bodri/RcReceiver/RcReceiver.kicad_pcb

## KiCad design RcReceiver.kicad_pcb (2019-04-16)

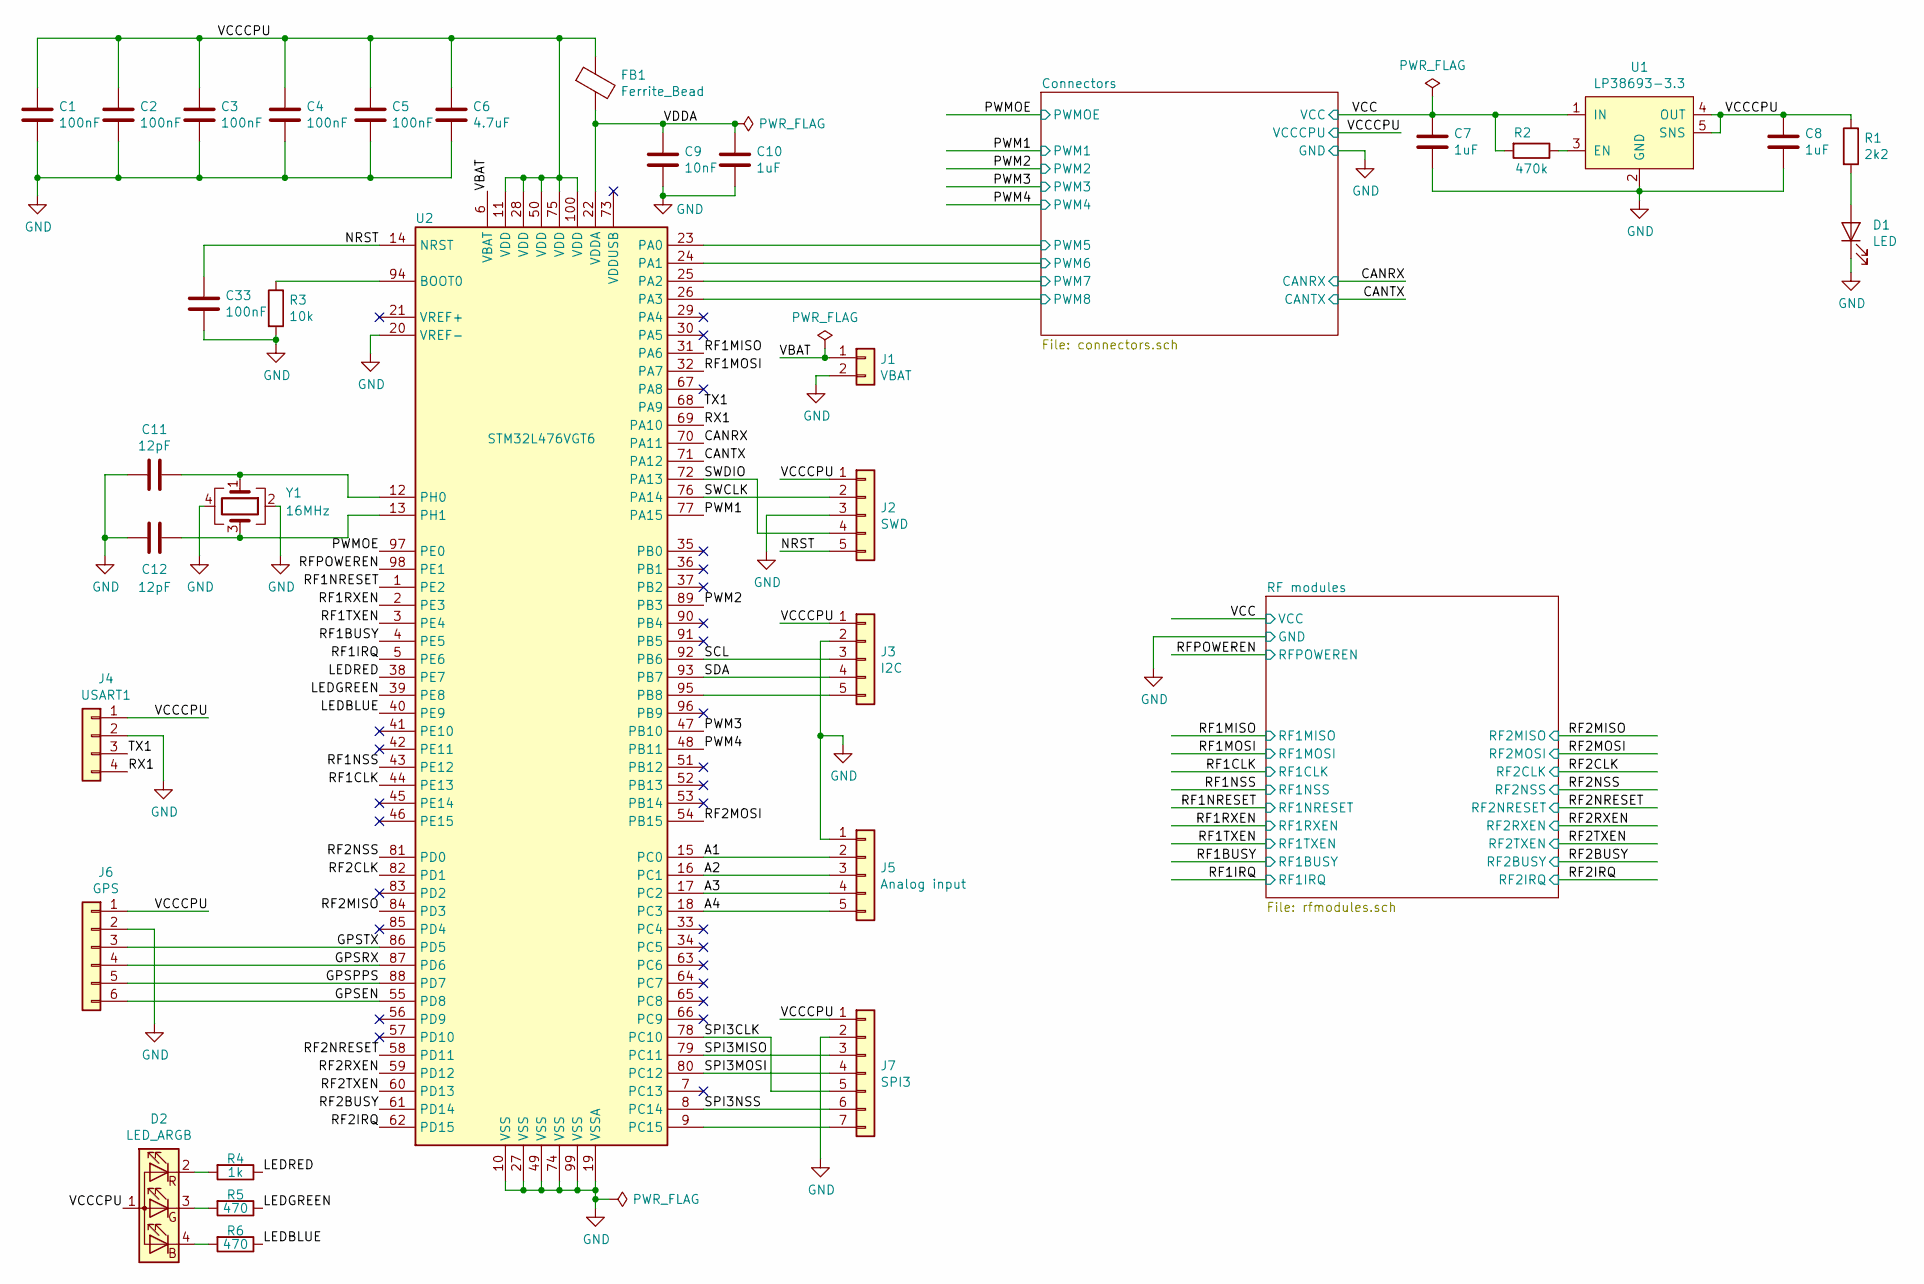
[picture p1: schematic RcReceiver.sch, SX1280 based RC receiver]

Parts:
C1, C2, C3, C4, C5, C33: 100nF; C_0402_1005Metric
C6: 4.7uF; C_0402_1005Metric
C7, C8, C10: 1uF; C_0402_1005Metric
C9: 10nF; C_0402_1005Metric
C11, C12: 12pF; C_0402_1005Metric
D1: LED; LED_0402_1005Metric
D2: LED_ARGB; LED_Lumex-LX0404
FB1: Ferrite_Bead; L_0402_1005Metric
J1: VBAT; PinHeader_1x02_P1.27mm_Vertical
J2: SWD; JST_SH_BM05B-SRSS-TB_1x05-1MP_P1.00mm_Vertical
J3: I2C; JST_SH_BM05B-SRSS-TB_1x05-1MP_P1.00mm_Vertical
J4: USART1; JST_SH_BM04B-SRSS-TB_1x04-1MP_P1.00mm_Vertical
J5: Analog input; JST_SH_BM05B-SRSS-TB_1x05-1MP_P1.00mm_Vertical
J6: GPS; JST_SH_BM06B-SRSS-TB_1x06-1MP_P1.00mm_Vertical
J7: SPI3; JST_SH_BM07B-SRSS-TB_1x07-1MP_P1.00mm_Vertical
R1: 2k2; R_0402_1005Metric
R2: 470k; R_0402_1005Metric
R3: 10k; R_0402_1005Metric
R4: 1k; R_0402_1005Metric
R5, R6: 470; R_0402_1005Metric
U1: LP38693-3.3; WSON-6_3x3mm_Pitch0.95mm
U2: STM32L476VGT6; LQFP-100_14x14mm_P0.5mm
Y1: 16MHz; Oscillator_SMD_SeikoEpson_SG210-4Pin_2.5x2.0mm

Connections:
/A1: J5.2, U2.15 (PC0)
/A2: J5.3, U2.16 (PC1)
/A3: J5.4, U2.17 (PC2)
/A4: J5.5, U2.18 (PC3)
/CANRX: U2.70 (PA11); also elsewhere on the board
/CANTX: U2.71 (PA12); also elsewhere on the board
/Connectors/PWM5: U2.23 (PA0); also elsewhere on the board
/Connectors/PWM6: U2.24 (PA1); also elsewhere on the board
/Connectors/PWM7: U2.25 (PA2); also elsewhere on the board
/Connectors/PWM8: U2.26 (PA3); also elsewhere on the board
/GPSEN: J6.6, U2.55 (PD8)
/GPSPPS: J6.5, U2.88 (PD7)
/GPSRX: J6.4, U2.87 (PD6)
/GPSTX: J6.3, U2.86 (PD5)
/LEDBLUE: R6.1, U2.40 (PE9)
/LEDGREEN: R5.1, U2.39 (PE8)
/LEDRED: R4.1, U2.38 (PE7)
/NRST: C33.1, J2.5, U2.14 (NRST)
/PWM1: U2.77 (PA15); also elsewhere on the board
/PWM2: U2.89 (PB3); also elsewhere on the board
/PWM3: U2.47 (PB10); also elsewhere on the board
/PWM4: U2.48 (PB11); also elsewhere on the board
/PWMOE: U2.97 (PE0); also elsewhere on the board
/RF1BUSY: U2.4 (PE5); also elsewhere on the board
/RF1CLK: U2.44 (PE13); also elsewhere on the board
/RF1IRQ: U2.5 (PE6); also elsewhere on the board
/RF1MISO: U2.31 (PA6); also elsewhere on the board
/RF1MOSI: U2.32 (PA7); also elsewhere on the board
/RF1NRESET: U2.1 (PE2); also elsewhere on the board
/RF1NSS: U2.43 (PE12); also elsewhere on the board
/RF1RXEN: U2.2 (PE3); also elsewhere on the board
/RF1TXEN: U2.3 (PE4); also elsewhere on the board
/RF2BUSY: U2.61 (PD14); also elsewhere on the board
/RF2CLK: U2.82 (PD1); also elsewhere on the board
/RF2IRQ: U2.62 (PD15); also elsewhere on the board
/RF2MISO: U2.84 (PD3); also elsewhere on the board
/RF2MOSI: U2.54 (PB15); also elsewhere on the board
/RF2NRESET: U2.58 (PD11); also elsewhere on the board
/RF2NSS: U2.81 (PD0); also elsewhere on the board
/RF2RXEN: U2.59 (PD12); also elsewhere on the board
/RF2TXEN: U2.60 (PD13); also elsewhere on the board
/RFPOWEREN: U2.98 (PE1); also elsewhere on the board
/RX1: J4.4, U2.69 (PA10)
/SCL: J3.3, U2.92 (PB6)
/SDA: J3.4, U2.93 (PB7)
/SPI3CLK: J7.5, U2.78 (PC10)
/SPI3MISO: J7.3, U2.79 (PC11)
/SPI3MOSI: J7.4, U2.80 (PC12)
/SPI3NSS: J7.6, U2.8 (PC14)
/SWCLK: J2.2, U2.76 (PA14)
/SWDIO: J2.4, U2.72 (PA13)
/TX1: J4.3, U2.68 (PA9)
/VBAT: J1.1, U2.6 (VBAT)
/VCCCPU: C1.1, C2.1, C3.1, C4.1, C5.1, C6.1, C8.1, D2.1 (A), FB1.1, J2.1, J3.1, J4.1, J6.1, J7.1, R1.1, U1.4 (OUT), U1.5 (SNS), U2.11 (VDD), U2.28 (VDD), U2.50 (VDD), U2.75 (VDD), U2.100 (VDD); also elsewhere on the board
/VDDA: C9.1, C10.1, FB1.2, U2.22 (VDDA)
GND: C1.2, C2.2, C3.2, C4.2, C5.2, C6.2, C7.2, C8.2, C9.2, C10.2, C11.2, C12.2, C33.2, D1.1 (K), J1.2, J2.3, J3.2, J4.2, J5.1, J6.2, J7.2, R3.2, U1.2 (GND), U1.7 (GND), U2.10 (VSS), U2.19 (VSSA), U2.20 (VREF-), U2.27 (VSS), U2.49 (VSS), U2.74 (VSS), U2.99 (VSS), Y1.2, Y1.4; also elsewhere on the board
IN: C7.1, R2.2, U1.1 (IN), U1.6 (IN); also elsewhere on the board
unnamed: C11.1, U2.12 (PH0), Y1.1
unnamed: C12.1, U2.13 (PH1), Y1.3
unnamed: D1.2 (A), R1.2
unnamed: D2.2 (RK), R4.2
unnamed: D2.3 (GK), R5.2
unnamed: D2.4 (BK), R6.2
unnamed: J3.5, U2.95 (PB8)
unnamed: J7.7, U2.9 (PC15)
unnamed: R2.1, U1.3 (EN)
unnamed: R3.1, U2.94 (BOOT0)

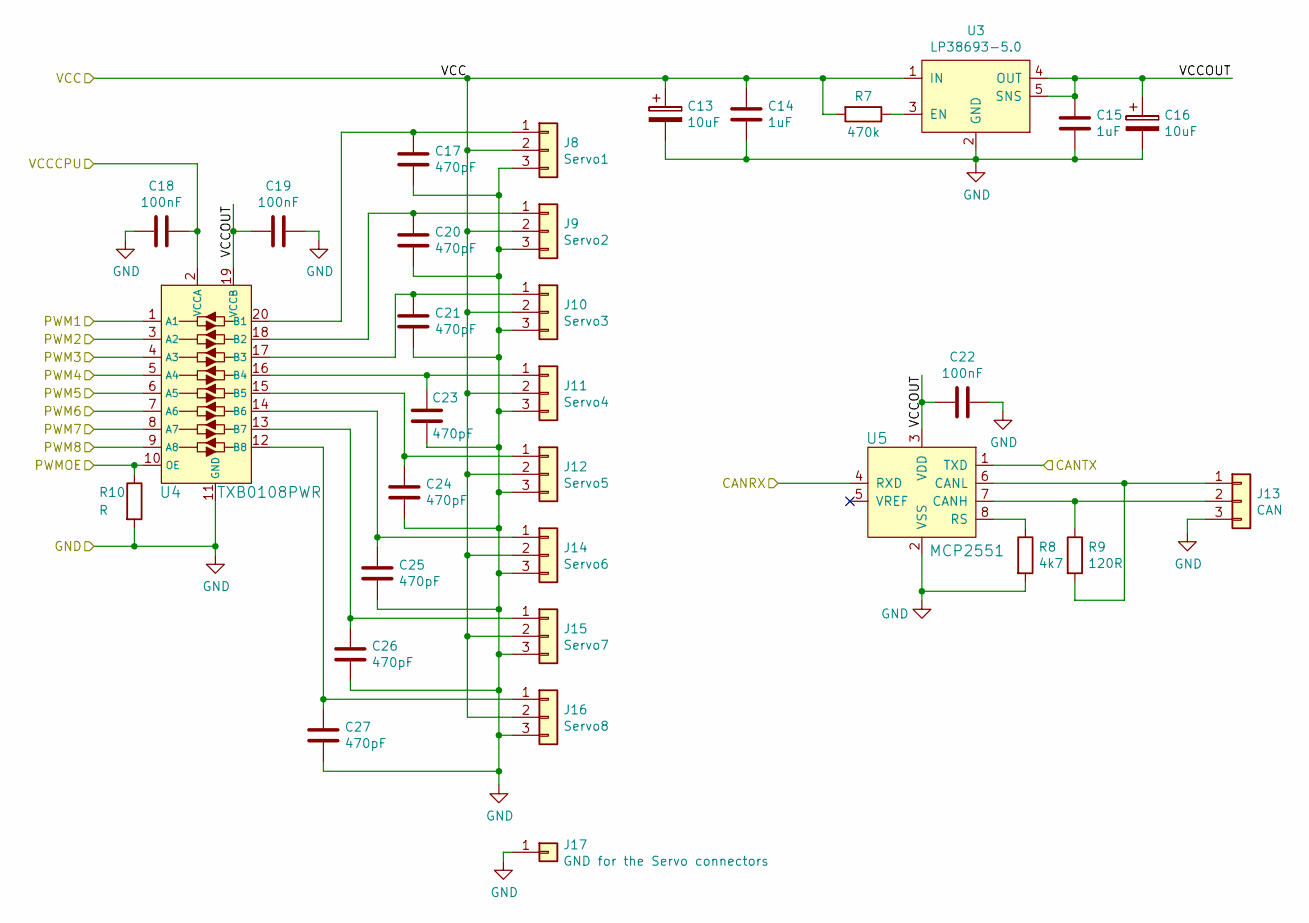
[picture p2: schematic connectors.sch, SX1280 based RC receiver]

Parts:
C13, C16: 10uF; CP_EIA-3216-18_Kemet-A
C14, C15: 1uF; C_0402_1005Metric
C17, C20, C21, C23, C24, C25, C26, C27: 470pF; C_0402_1005Metric
C18, C19, C22: 100nF; C_0402_1005Metric
J8: Servo1; PinHeader_1x03_P1.27mm_Side
J9: Servo2; PinHeader_1x03_P1.27mm_Side
J10: Servo3; PinHeader_1x03_P1.27mm_Side
J11: Servo4; PinHeader_1x03_P1.27mm_Side
J12: Servo5; PinHeader_1x03_P1.27mm_Side
J13: CAN; JST_SH_BM03B-SRSS-TB_1x03-1MP_P1.00mm_Vertical
J14: Servo6; PinHeader_1x03_P1.27mm_Side
J15: Servo7; PinHeader_1x03_P1.27mm_Side
J16: Servo8; PinHeader_1x03_P1.27mm_Side
J17: GND for the Servo connectors; PinHeader_1x01_P2.54mm_Vertical
R7: 470k; R_0402_1005Metric
R8: 4k7; R_0402_1005Metric
R9: 120R; R_0402_1005Metric
R10: R; R_0402_1005Metric
U3: LP38693-5.0; WSON-6_3x3mm_Pitch0.95mm
U4: TXB0108PWR; TSSOP-20_W4.4mm; MPN TXB0108PWR; Digi-Key_PN 296-21527-1-ND
U5: MCP2551; SOIC-8_W3.9mm; MPN MCP2551-I/SN; Digi-Key_PN MCP2551-I/SN-ND

Connections:
/CANRX: U5.4 (RXD); also elsewhere on the board
/CANTX: U5.1 (TXD); also elsewhere on the board
/Connectors/PWM5: U4.6 (A5); also elsewhere on the board
/Connectors/PWM6: U4.7 (A6); also elsewhere on the board
/Connectors/PWM7: U4.8 (A7); also elsewhere on the board
/Connectors/PWM8: U4.9 (A8); also elsewhere on the board
/Connectors/VCCOUT: C15.1, C16.1, C19.2, C22.2, U3.4 (OUT), U3.5 (SNS), U4.19 (VCCB), U5.3 (VDD)
/PWM1: U4.1 (A1); also elsewhere on the board
/PWM2: U4.3 (A2); also elsewhere on the board
/PWM3: U4.4 (A3); also elsewhere on the board
/PWM4: U4.5 (A4); also elsewhere on the board
/PWMOE: R10.1, U4.10 (OE); also elsewhere on the board
/VCCCPU: C18.1, U4.2 (VCCA); also elsewhere on the board
GND: C13.2, C14.2, C15.2, C16.2, C17.2, C18.2, C19.1, C20.2, C21.2, C22.1, C23.2, C24.2, C25.2, C26.2, C27.2, J8.3, J9.3, J10.3, J11.3, J12.3, J13.3, J14.3, J15.3, J16.3, J17.1, R8.2, R10.2, U3.2 (GND), U3.7 (GND), U4.11 (GND), U5.2 (VSS); also elsewhere on the board
IN: C13.1, C14.1, J8.2, J9.2, J10.2, J11.2, J12.2, J14.2, J15.2, J16.2, R7.2, U3.1 (IN), U3.6 (IN); also elsewhere on the board
unnamed: C17.1, J8.1, U4.20 (B1)
unnamed 66: C20.1, J9.1, U4.18 (B2); also elsewhere on the board
unnamed: C21.1, J10.1, U4.17 (B3)
unnamed: C23.1, J11.1, U4.16 (B4)
unnamed: C24.1, J12.1, U4.15 (B5)
unnamed: C25.1, J14.1, U4.14 (B6)
unnamed: C26.1, J15.1, U4.13 (B7)
unnamed: C27.1, J16.1, U4.12 (B8)
unnamed: J13.1, R9.2, U5.6 (CANL)
unnamed: J13.2, R9.1, U5.7 (CANH)
unnamed: R7.1, U3.3 (EN)
unnamed: R8.1, U5.8 (RS)

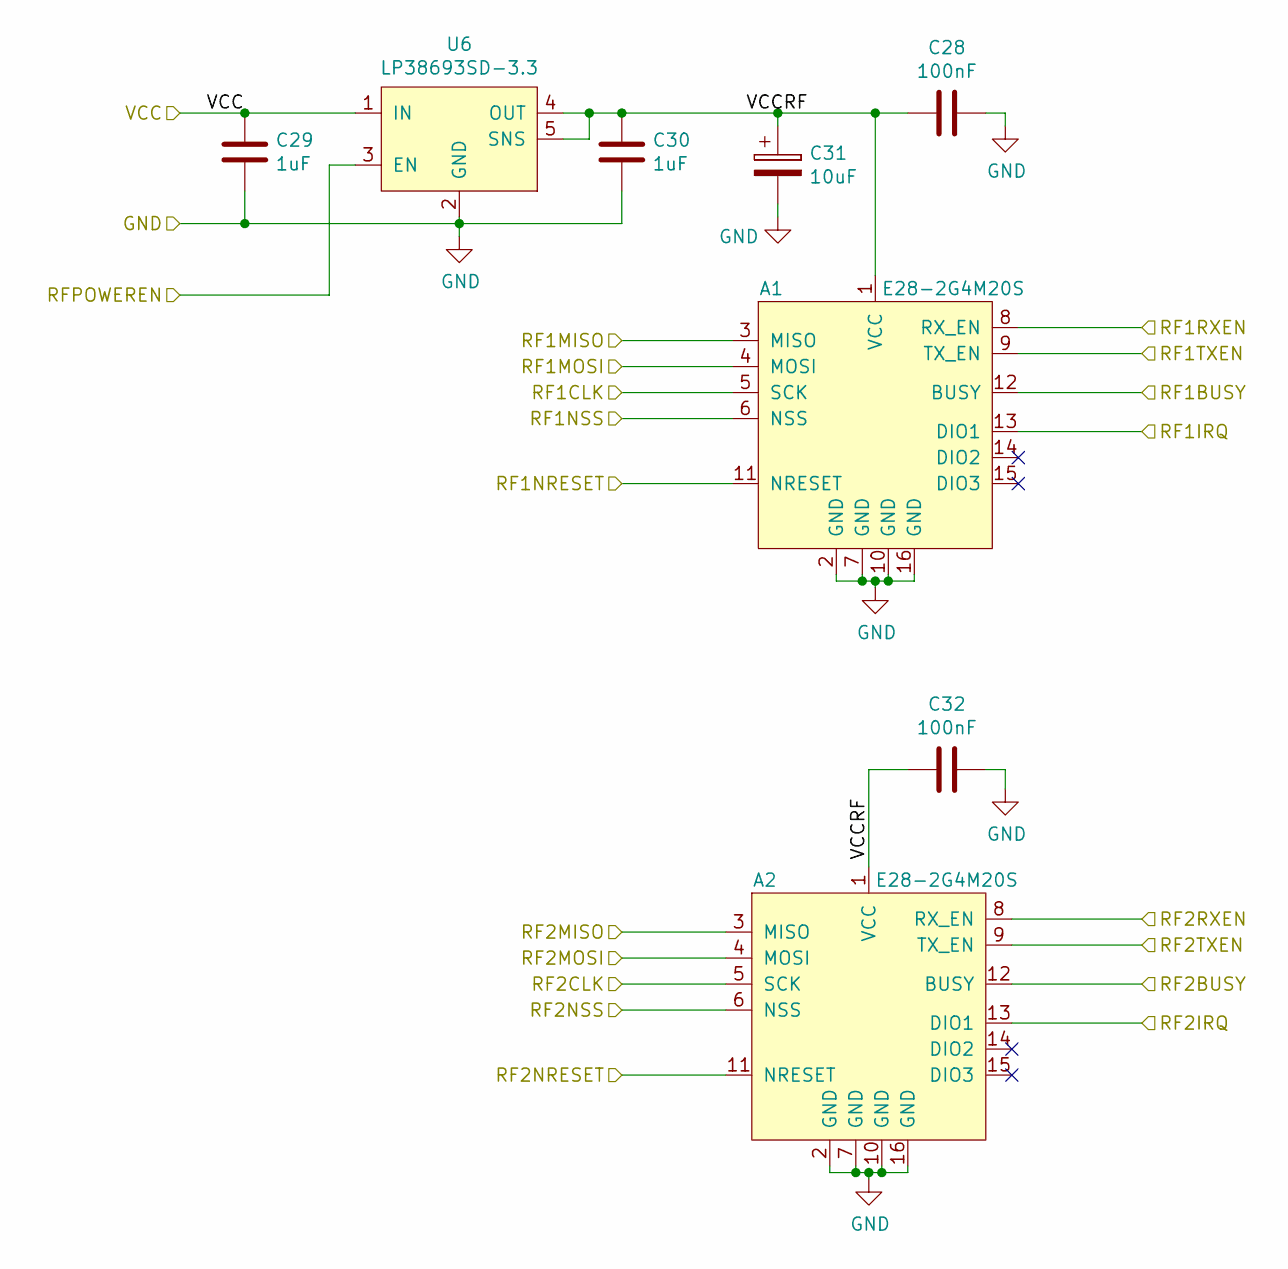
[picture p3: schematic rfmodules.sch, SX1280 based RC receiver]

Parts:
A1, A2: E28-2G4M20S
C28, C32: 100nF; C_0402_1005Metric
C29, C30: 1uF; C_0402_1005Metric
C31: 10uF; CP_EIA-3216-18_Kemet-A
U6: LP38693SD-3.3; WSON-6_3x3mm_Pitch0.95mm

Connections:
/RF1BUSY: A1.12 (BUSY); also elsewhere on the board
/RF1CLK: A1.5 (SCK); also elsewhere on the board
/RF1IRQ: A1.13 (DIO1); also elsewhere on the board
/RF1MISO: A1.3 (MISO); also elsewhere on the board
/RF1MOSI: A1.4 (MOSI); also elsewhere on the board
/RF1NRESET: A1.11 (NRESET); also elsewhere on the board
/RF1NSS: A1.6 (NSS); also elsewhere on the board
/RF1RXEN: A1.8 (RX_EN); also elsewhere on the board
/RF1TXEN: A1.9 (TX_EN); also elsewhere on the board
/RF2BUSY: A2.12 (BUSY); also elsewhere on the board
/RF2CLK: A2.5 (SCK); also elsewhere on the board
/RF2IRQ: A2.13 (DIO1); also elsewhere on the board
/RF2MISO: A2.3 (MISO); also elsewhere on the board
/RF2MOSI: A2.4 (MOSI); also elsewhere on the board
/RF2NRESET: A2.11 (NRESET); also elsewhere on the board
/RF2NSS: A2.6 (NSS); also elsewhere on the board
/RF2RXEN: A2.8 (RX_EN); also elsewhere on the board
/RF2TXEN: A2.9 (TX_EN); also elsewhere on the board
/RF modules/VCCRF: A1.1 (VCC), A2.1 (VCC), C28.2, C30.1, C31.1, C32.2, U6.4 (OUT), U6.5 (SNS)
/RFPOWEREN: U6.3 (EN); also elsewhere on the board
GND: A1.2 (GND), A1.7 (GND), A1.10 (GND), A1.16 (GND), A2.2 (GND), A2.7 (GND), A2.10 (GND), A2.16 (GND), C28.1, C29.2, C30.2, C31.2, C32.1, U6.2 (GND), U6.7 (GND); also elsewhere on the board
IN: C29.1, U6.1 (IN), U6.6 (IN); also elsewhere on the board

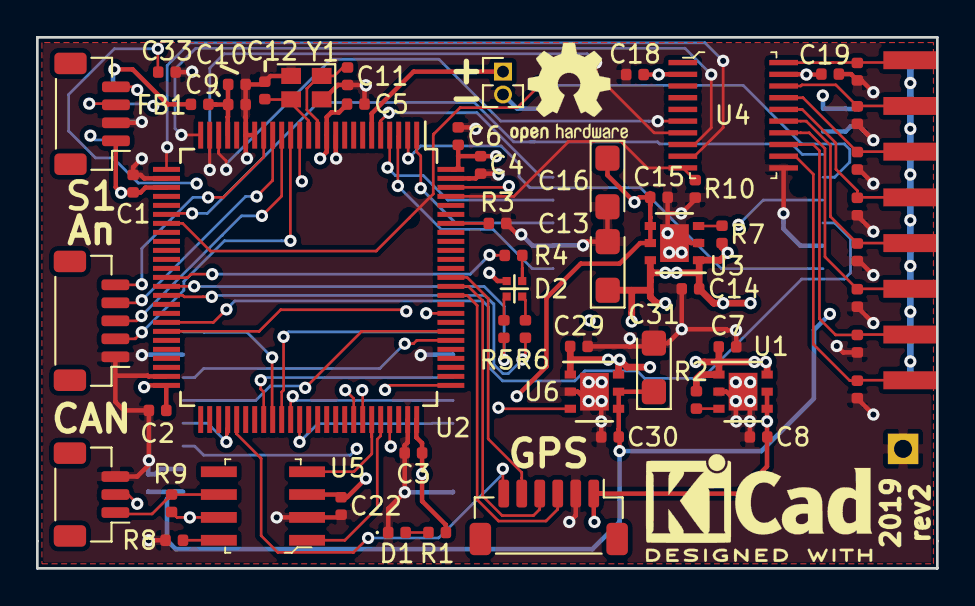
[picture p4: board RcReceiver.kicad_pcb from above]

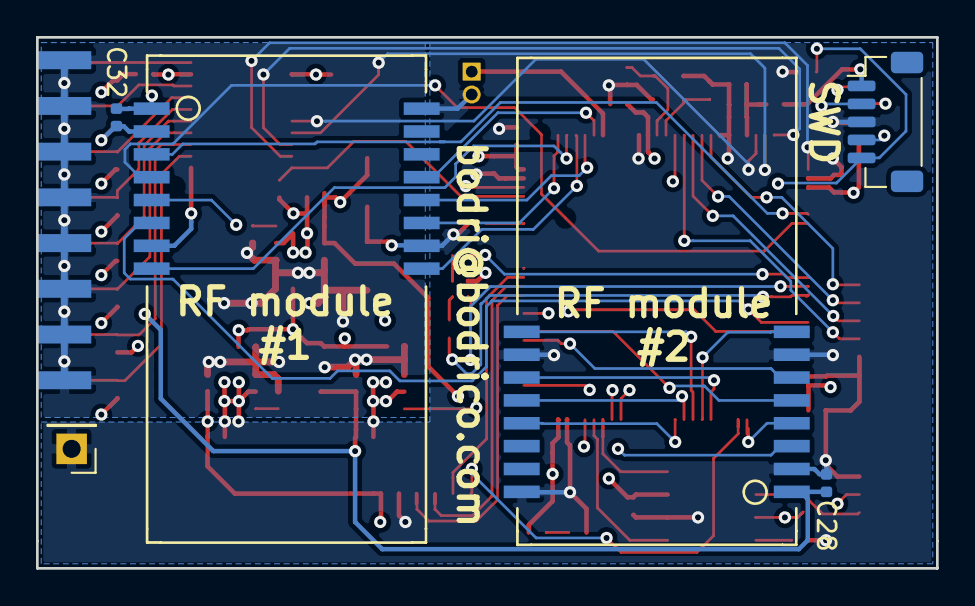
[picture p5: board RcReceiver.kicad_pcb from below]

Board: 4 copper layers, 50.0 x 29.5 mm, 72 parts (6 on the bottom side), 73 nets.

Other parts of the board:
KICADLOGO: KiCad-Logo2_6mm_SilkScreen
OSHLOGO: OSHW-Logo2_7.3x6mm_SilkScreen
wC20: 470pF; C_0402_1005Metric

Their connections:
GND: wC20.2; also elsewhere on the board
unnamed 66: wC20.1; also elsewhere on the board
