bodri/RcReceiver/(commit log)

2019-02-26 Add processor
    [RcReceiver.kicad_pcb, RcReceiver.sch]
2019-02-27 Add connectors
    [RcReceiver.sch]
2019-02-27 Add footprints
    [RcReceiver.sch, connectors.sch]
2019-02-27 Add missing pins and keep-out zone
    [RcReceiver.kicad_pcb, connectors.sch]
2019-03-03 Add schema with RF modules
    [RcReceiver.sch, connectors.sch, rfmodules.sch]
2019-03-03 Small changes
    [RcReceiver.sch, connectors.sch, rfmodules.sch]
2019-03-07 Final changes in schema
    [RcReceiver.sch, connectors.sch, rfmodules.sch]
2019-03-07 Add some footprints
    [RcReceiver.kicad_pcb, RcReceiver.sch, connectors.sch, rfmodules.sch]
2019-03-08 Create PCB
    [RcReceiver.kicad_pcb, RcReceiver.sch, connectors.sch, rfmodules.sch]
2019-03-09 Place all the components on the board
    [RcReceiver.kicad_pcb, RcReceiver.sch, connectors.sch]
2019-03-14 Start routing
    [RcReceiver.kicad_pcb]
2019-03-14 Fix multiple REF problem
    [RcReceiver.kicad_pcb]
2019-03-15 More routing
    [RcReceiver.kicad_pcb]
2019-03-16 Routing finished
    [RcReceiver.kicad_pcb]
2019-03-16 Add fill zones
    [RcReceiver.kicad_pcb]
2019-04-16 Change TBX0108 footprint
    [RcReceiver.kicad_pcb, connectors.sch]
